MasasDev/custom-esp32-iot-pcb/esp32-c3-02.kicad_sch

## KiCad design esp32-c3-02.kicad_sch (2025-07-18)

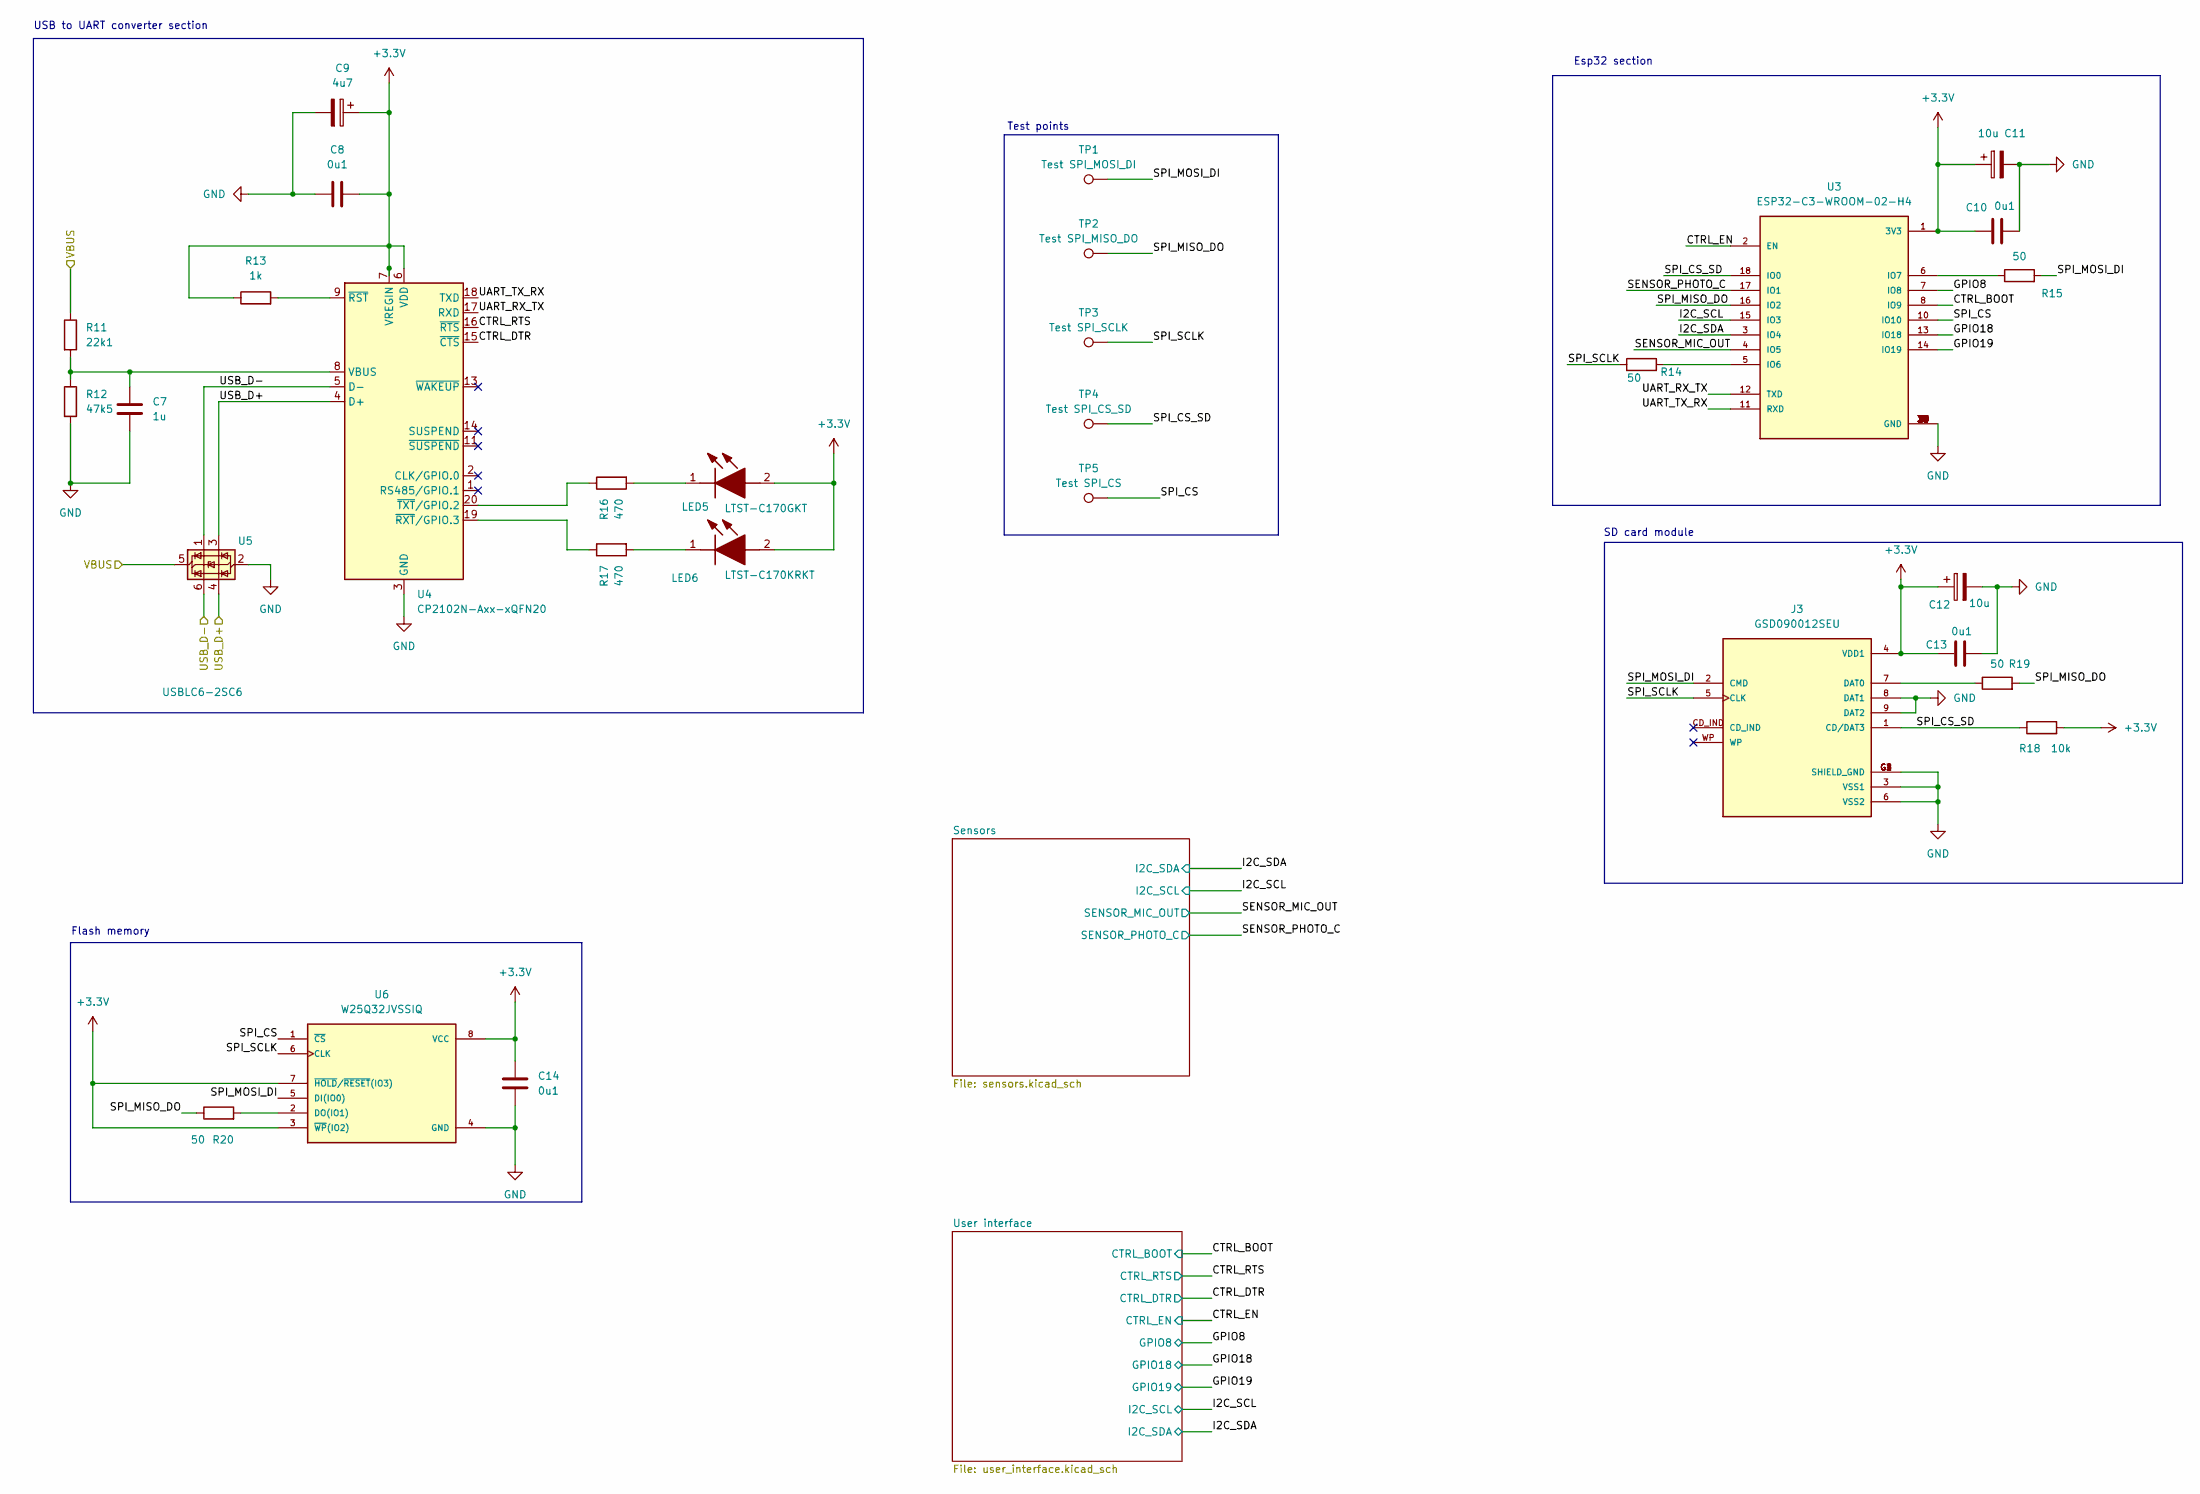
[picture p1: schematic esp32-c3-02.kicad_sch]

Parts:
C7: 1u; C_0805_2012Metric
C8, C10, C13, C14: 0u1; C_0805_2012Metric
C9: 4u7; T491A
C11, C12: 10u; T491A
J3: GSD090012SEU; AMPHENOL_GSD090012SEU; PARTREV E
LED5: LTST-C170GKT; LEDC2012X120N; Manufacturer_Part_Number LTST-C170GKT; Mouser Part Number 859-LTST-C170GKT
LED6: LTST-C170KRKT; LEDC2012X120N; Manufacturer_Part_Number LTST-C170KRKT; Mouser Part Number 859-LTST-C170KRKT
R11: 22k1; R_0805_2012Metric
R12: 47k5; R_0805_2012Metric
R13: 1k; R_0805_2012Metric
R14, R15, R19, R20: 50; R_0805_2012Metric
R16, R17: 470; R_0805_2012Metric
R18: 10k; R_0805_2012Metric
TP1: Test SPI_MOSI_DI; TestPoint_Pad_D1.0mm
TP2: Test SPI_MISO_DO; TestPoint_Pad_D1.0mm
TP3: Test SPI_SCLK; TestPoint_Pad_D1.0mm
TP4: Test SPI_CS_SD; TestPoint_Pad_D1.0mm
TP5: Test SPI_CS; TestPoint_Pad_D1.0mm
U3: ESP32-C3-WROOM-02-H4; MODULE_ESP32-C3-WROOM-02-H4
U4: CP2102N-Axx-xQFN20; SiliconLabs_QFN-20-1EP_3x3mm_P0.5mm
U5: USBLC6-2SC6; SOT-23-6
U6: W25Q32JVSSIQ; SOIC127P790X216-8N; M_PART_NUMBER W25QXX

Connections:
+3.3V: C8.2, C9.1, C10.1, C11.1, C12.1, C13.1, C14.1, J3.4 (VDD1), LED5.2 (A), LED6.2 (A), R13.1, R18.2, U3.1 (3V3), U4.6 (VDD), U4.7 (VREGIN), U6.3 (~WP(IO2)), U6.7 (~HOLD/~RESET(IO3)), U6.8 (VCC)
CTRL_BOOT: U3.8 (IO9)
CTRL_DTR: U4.15 (~CTS)
CTRL_EN: U3.2 (EN)
CTRL_RTS: U4.16 (~RTS)
GND: C7.2, C8.1, C9.2, C10.2, C11.2, C12.2, C13.2, C14.2, J3.3 (VSS1), J3.6 (VSS2), J3.8 (DAT1), J3.9 (DAT2), J3.G1 (SHIELD_GND), J3.G2 (SHIELD_GND), J3.G3 (SHIELD_GND), J3.G4 (SHIELD_GND), R12.2, U3.9 (GND), U3.19 (GND), U3.20 (GND), U3.21 (GND), U3.22 (GND), U3.23 (GND), U3.24 (GND), U3.25 (GND), U3.26 (GND), U3.27 (GND), U3.28 (GND), U3.29 (GND), U3.30 (GND), U3.31 (GND), U3.32 (GND), U3.33 (GND), U3.34 (GND), U3.35 (GND), U3.36 (GND), U3.37 (GND), U3.38 (GND), U3.39 (GND), U4.3 (GND), U4.12 (GND), U4.21 (GND), U5.2 (GND), U6.4 (GND)
GPIO8: U3.7 (IO8)
GPIO18: U3.13 (IO18)
GPIO19: U3.14 (IO19)
I2C_SCL: U3.15 (IO3)
I2C_SDA: U3.3 (IO4)
unnamed: C7.1, R11.2, R12.1, U4.8 (VBUS)
unnamed: J3.7 (DAT0), R19.1
unnamed: LED5.1 (K), R16.2
unnamed: LED6.1 (K), R17.2
unnamed: R13.2, U4.9 (~RST)
unnamed: R14.2, U3.5 (IO6)
unnamed: R15.1, U3.6 (IO7)
unnamed: R16.1, U4.20 (~TXT/GPIO.2)
unnamed: R17.1, U4.19 (~RXT/GPIO.3)
unnamed: R20.2, U6.2 (DO(IO1))
SENSOR_MIC_OUT: U3.4 (IO5)
SENSOR_PHOTO_C: U3.17 (IO1)
SPI_CS: TP5.1, U3.10 (IO10), U6.1 (~CS)
SPI_CS_SD: J3.1 (CD/DAT3), R18.1, TP4.1, U3.18 (IO0)
SPI_MISO_DO: R19.2, R20.1, TP2.1, U3.16 (IO2)
SPI_MOSI_DI: J3.2 (CMD), R15.2, TP1.1, U6.5 (DI(IO0))
SPI_SCLK: J3.5 (CLK), R14.1, TP3.1, U6.6 (CLK)
UART_RX_TX: U3.12 (TXD), U4.17 (RXD)
UART_TX_RX: U3.11 (RXD), U4.18 (TXD)
USB_D+: U4.4 (D+), U5.3 (I/O2), U5.4 (I/O2)
USB_D-: U4.5 (D-), U5.1 (I/O1), U5.6 (I/O1)
VBUS: R11.1, U5.5 (VBUS)

Notes on the sheet:
Test points
USB to UART converter section
Flash memory
Esp32 section
SD card module
