MasasDev/custom-esp32-iot-pcb/esp32_iot_board.kicad_sch

## KiCad design esp32_iot_board.kicad_sch (2025-07-18)

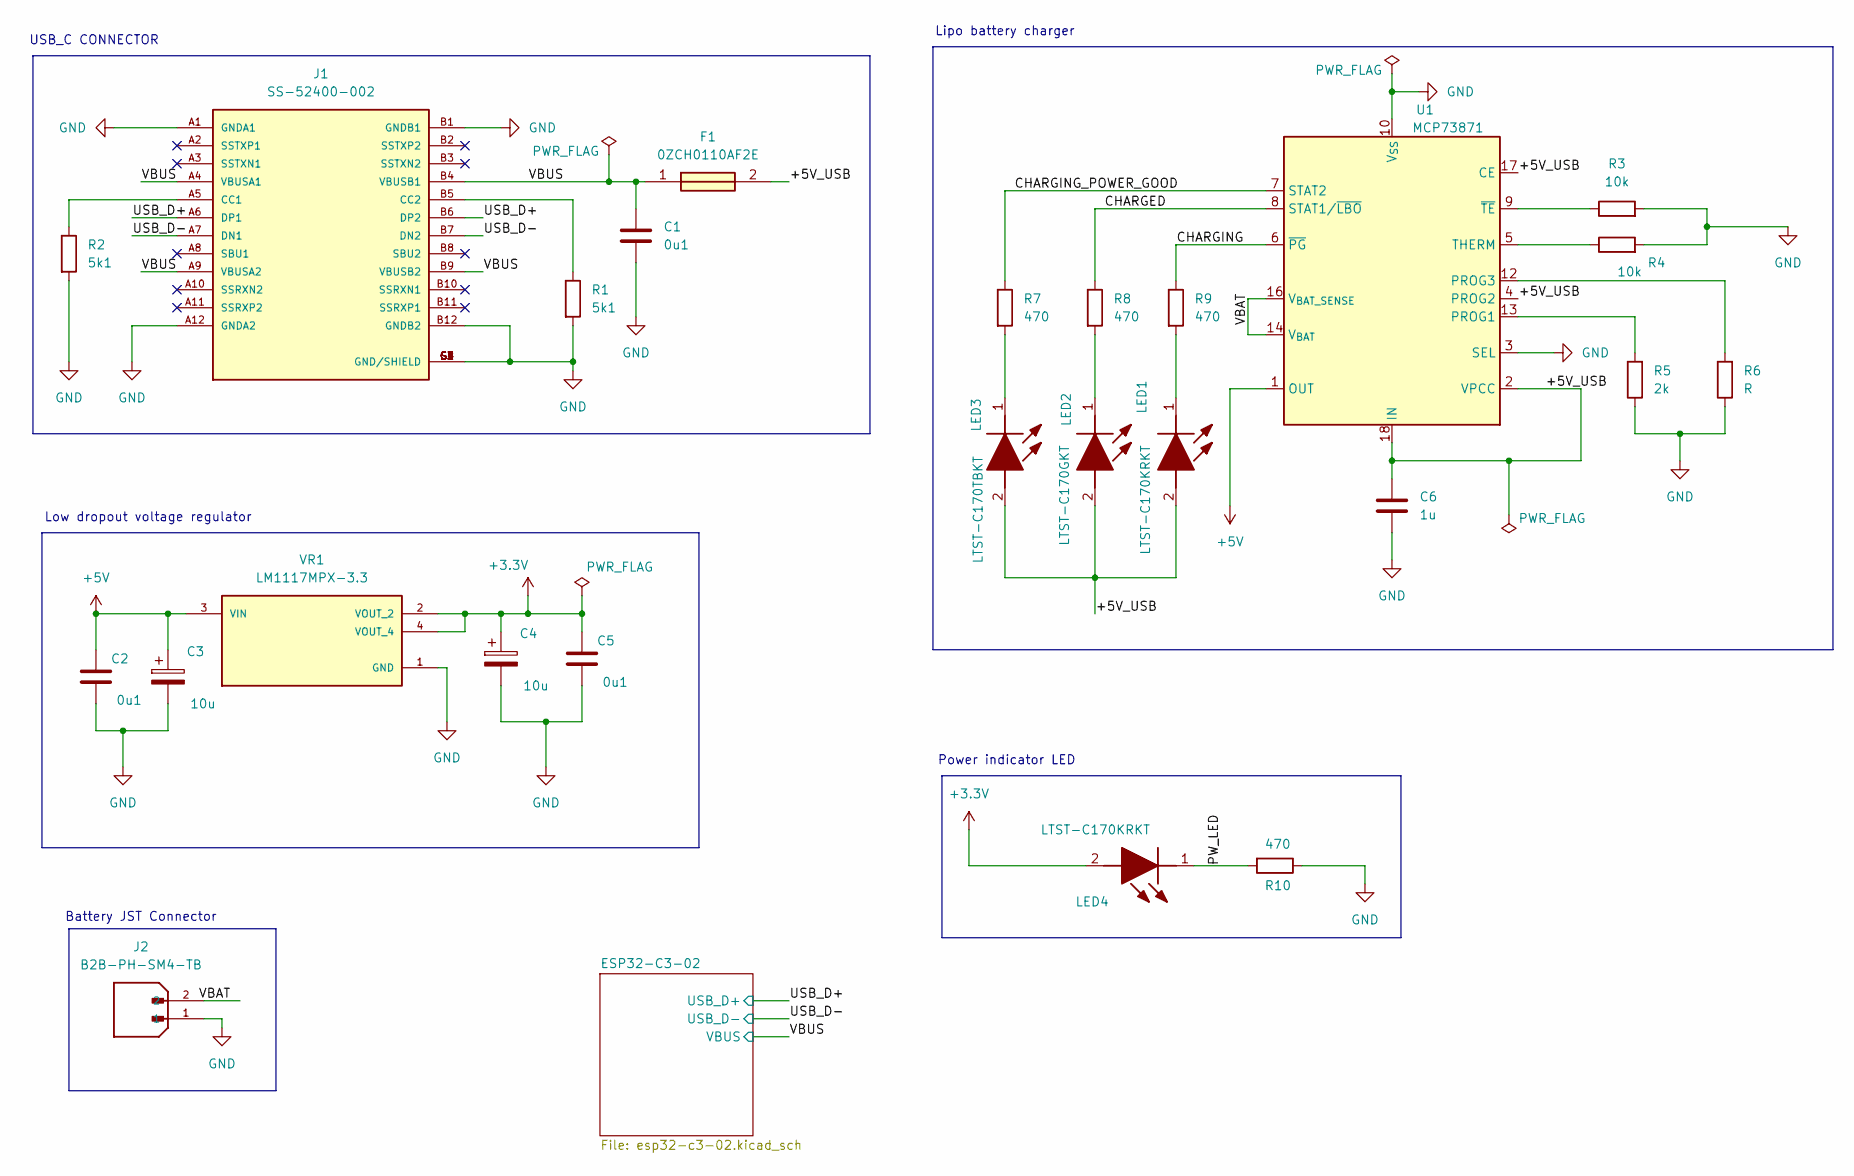
[picture p2: schematic esp32_iot_board.kicad_sch]

Parts:
C1, C2, C5: 0u1; C_0805_2012Metric
C3, C4: 10u; T491A
C6: 1u; C_0805_2012Metric
F1: 0ZCH0110AF2E; FUSC3226X100N; Manufacturer_Part_Number 0ZCH0110AF2E
J1: SS-52400-002; BELFUSE_SS-52400-002; PARTREV A0
J2: B2B-PH-SM4-TB; JST_B2B-PH-SM4-TB; PARTREV N/A
LED1, LED4: LTST-C170KRKT; LEDC2012X120N; Manufacturer_Part_Number LTST-C170KRKT; Mouser Part Number 859-LTST-C170KRKT
LED2: LTST-C170GKT; LEDC2012X120N; Manufacturer_Part_Number LTST-C170GKT; Mouser Part Number 859-LTST-C170GKT
LED3: LTST-C170TBKT; LEDC2012X120N; Manufacturer_Part_Number LTST-C170TBKT; Mouser Part Number 859-LTST-C170TBKT
R1, R2: 5k1; R_0805_2012Metric
R3, R4: 10k; R_0805_2012Metric
R5: 2k; R_0805_2012Metric
R6: R; R_0805_2012Metric
R7, R8, R9, R10: 470; R_0805_2012Metric
U1: MCP73871; QFN-20-1EP_4x4mm_P0.5mm_EP2.5x2.5mm
VR1: LM1117MPX-3.3; VREG_LM1117MPX-3.3

Connections:
+3.3V: C4.1, C5.1, LED4.2 (A), VR1.2 (VOUT_2), VR1.4 (VOUT_4)
+5V: C2.1, C3.1, U1.1 (OUT), U1.20 (OUT), VR1.3 (VIN)
+5V_USB: C6.1, F1.2, LED1.2 (A), LED2.2 (A), LED3.2 (A), U1.2 (VPCC), U1.4 (PROG2), U1.17 (CE), U1.18 (IN), U1.19 (IN)
CHARGED: R8.1, U1.8 (STAT1/~LBO)
CHARGING: R9.1, U1.6 (~PG)
CHARGING_POWER_GOOD: R7.1, U1.7 (STAT2)
GND: C1.2, C2.2, C3.2, C4.2, C5.2, C6.2, J1.A1 (GNDA1), J1.A12 (GNDA2), J1.B1 (GNDB1), J1.B12 (GNDB2), J1.G1 (GND/SHIELD), J1.G2 (GND/SHIELD), J1.G3 (GND/SHIELD), J1.G4 (GND/SHIELD), J1.S1 (GND/SHIELD), J1.S2 (GND/SHIELD), J1.S3 (GND/SHIELD), J1.S4 (GND/SHIELD), J2.1, R1.2, R2.2, R3.2, R4.2, R5.1, R6.1, R10.1, U1.3 (SEL), U1.10 (V_{SS}), U1.11 (V_{SS}), U1.21 (V_{SS}), VR1.1 (GND)
unnamed: J1.A5 (CC1), R2.1
unnamed: J1.B5 (CC2), R1.1
unnamed: LED1.1 (K), R9.2
unnamed: LED2.1 (K), R8.2
unnamed: LED3.1 (K), R7.2
unnamed: R3.1, U1.9 (~TE)
unnamed: R4.1, U1.5 (THERM)
unnamed: R5.2, U1.13 (PROG1)
unnamed: R6.2, U1.12 (PROG3)
PW_LED: LED4.1 (K), R10.2
USB_D+: J1.A6 (DP1), J1.B6 (DP2)
USB_D-: J1.A7 (DN1), J1.B7 (DN2)
VBAT: J2.2, U1.14 (V_{BAT}), U1.15 (V_{BAT}), U1.16 (V_{BAT_SENSE})
VBUS: C1.1, F1.1, J1.A4 (VBUSA1), J1.A9 (VBUSA2), J1.B4 (VBUSB1), J1.B9 (VBUSB2)

Notes on the sheet:
Lipo battery charger
Low dropout voltage regulator
Power indicator LED
USB_C CONNECTOR
Battery JST Connector
