MasasDev/custom-esp32-iot-pcb/sensors.kicad_sch

## KiCad design sensors.kicad_sch (2025-07-18)

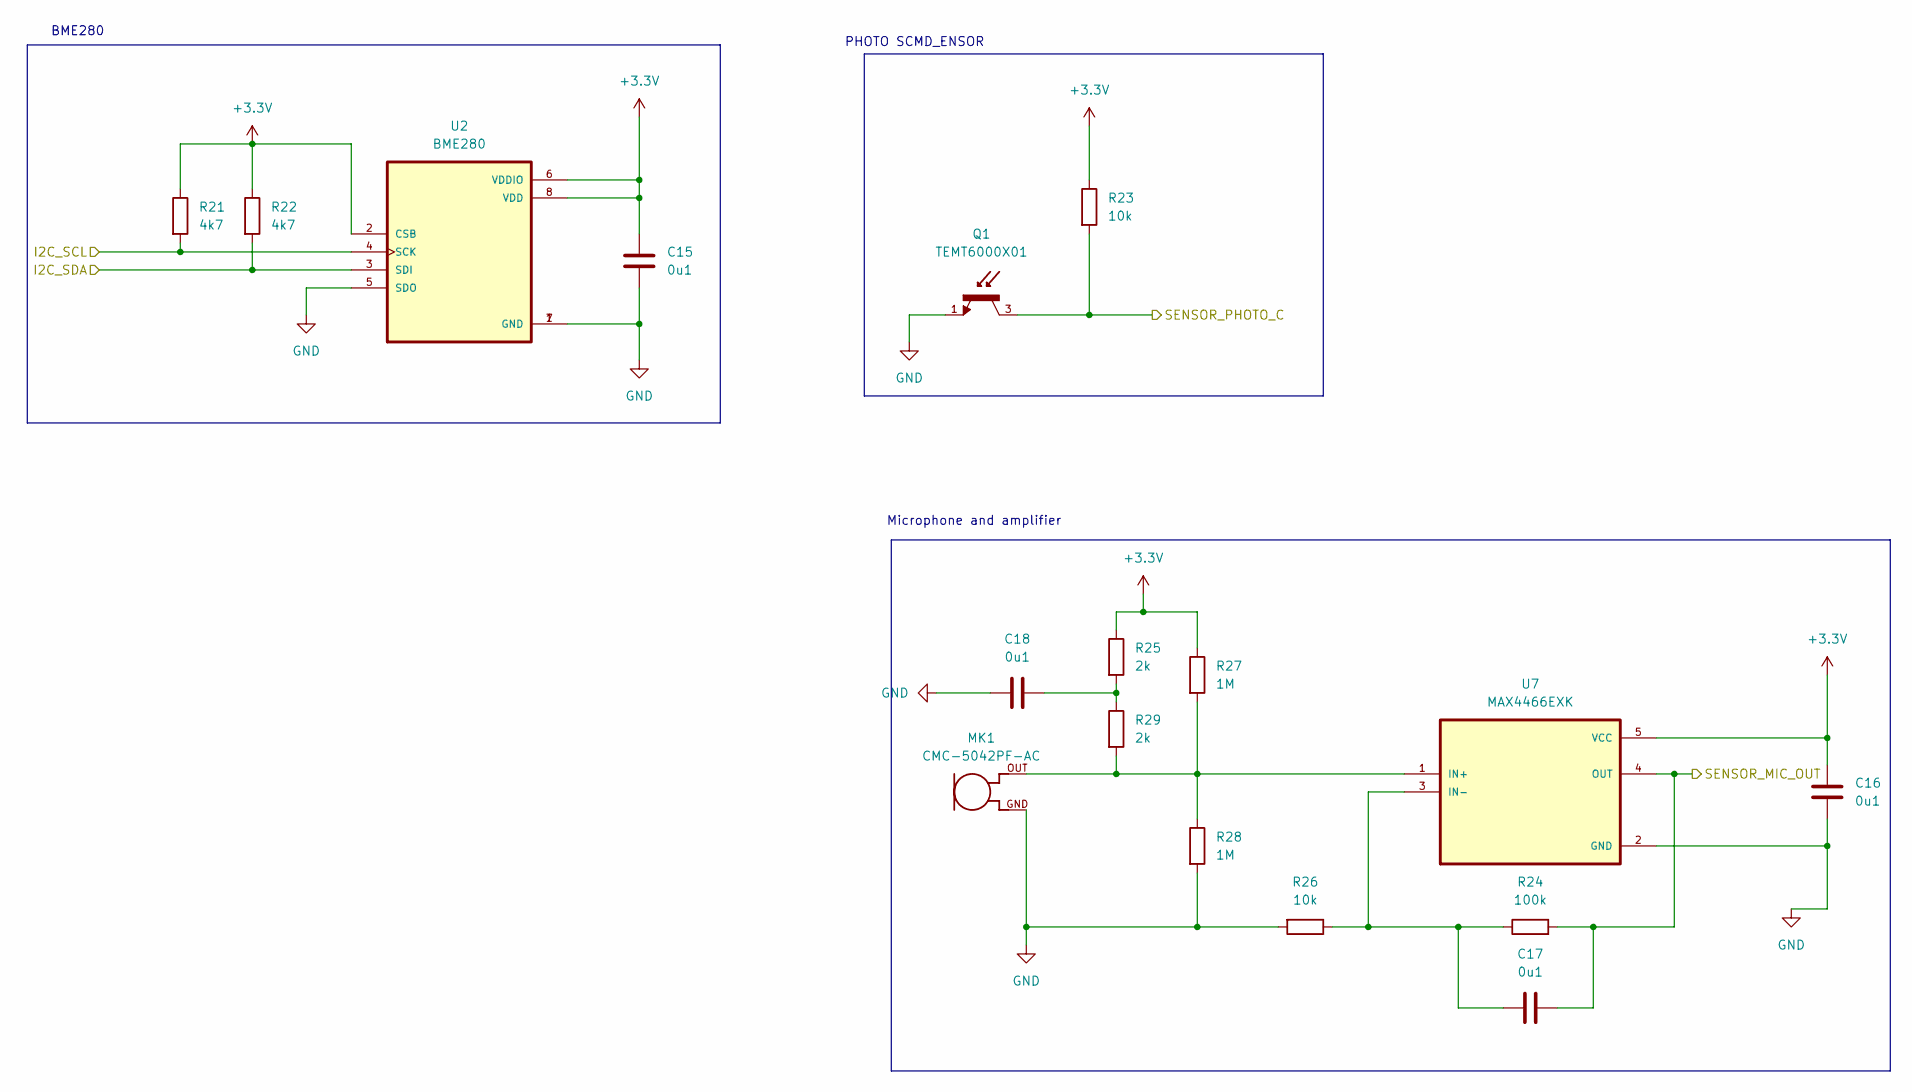
[picture p3: schematic sensors.kicad_sch]

Parts:
C15, C16, C17, C18: 0u1; C_0805_2012Metric
MK1: CMC-5042PF-AC; CUI_CMC-5042PF-AC
Q1: TEMT6000X01; TRANS_TEMT6000X01; PARTREV 1.9
R21, R22: 4k7; R_0805_2012Metric
R23, R26: 10k; R_0805_2012Metric
R24: 100k; R_0805_2012Metric
R25, R29: 2k; R_0805_2012Metric
R27, R28: 1M; R_0805_2012Metric
U2: BME280; PSON65P250X250X100-8N
U7: MAX4466EXK; SOT65P210X110-5N

Connections:
+3.3V: C15.1, C16.1, R21.1, R22.1, R23.1, R25.1, R27.1, U2.2 (CSB), U2.6 (VDDIO), U2.8 (VDD), U7.5 (VCC)
GND: C15.2, C16.2, C18.1, MK1.GND, Q1.1, R26.2, R28.2, U2.1 (GND), U2.5 (SDO), U2.7 (GND), U7.2 (GND)
I2C_SCL: R21.2, U2.4 (SCK)
I2C_SDA: R22.2, U2.3 (SDI)
unnamed: C17.1, R24.1, R26.1, U7.3 (IN-)
unnamed: C18.2, R25.2, R29.1
unnamed: MK1.OUT, R27.2, R28.1, R29.2, U7.1 (IN+)
SENSOR_MIC_OUT: C17.2, R24.2, U7.4 (OUT)
SENSOR_PHOTO_C: Q1.3, R23.2

Notes on the sheet:
Microphone and amplifier
PHOTO SCMD_ENSOR
BME280
