MasasDev/custom-esp32-iot-pcb/user_interface.kicad_sch

## KiCad design user_interface.kicad_sch (2025-07-18)

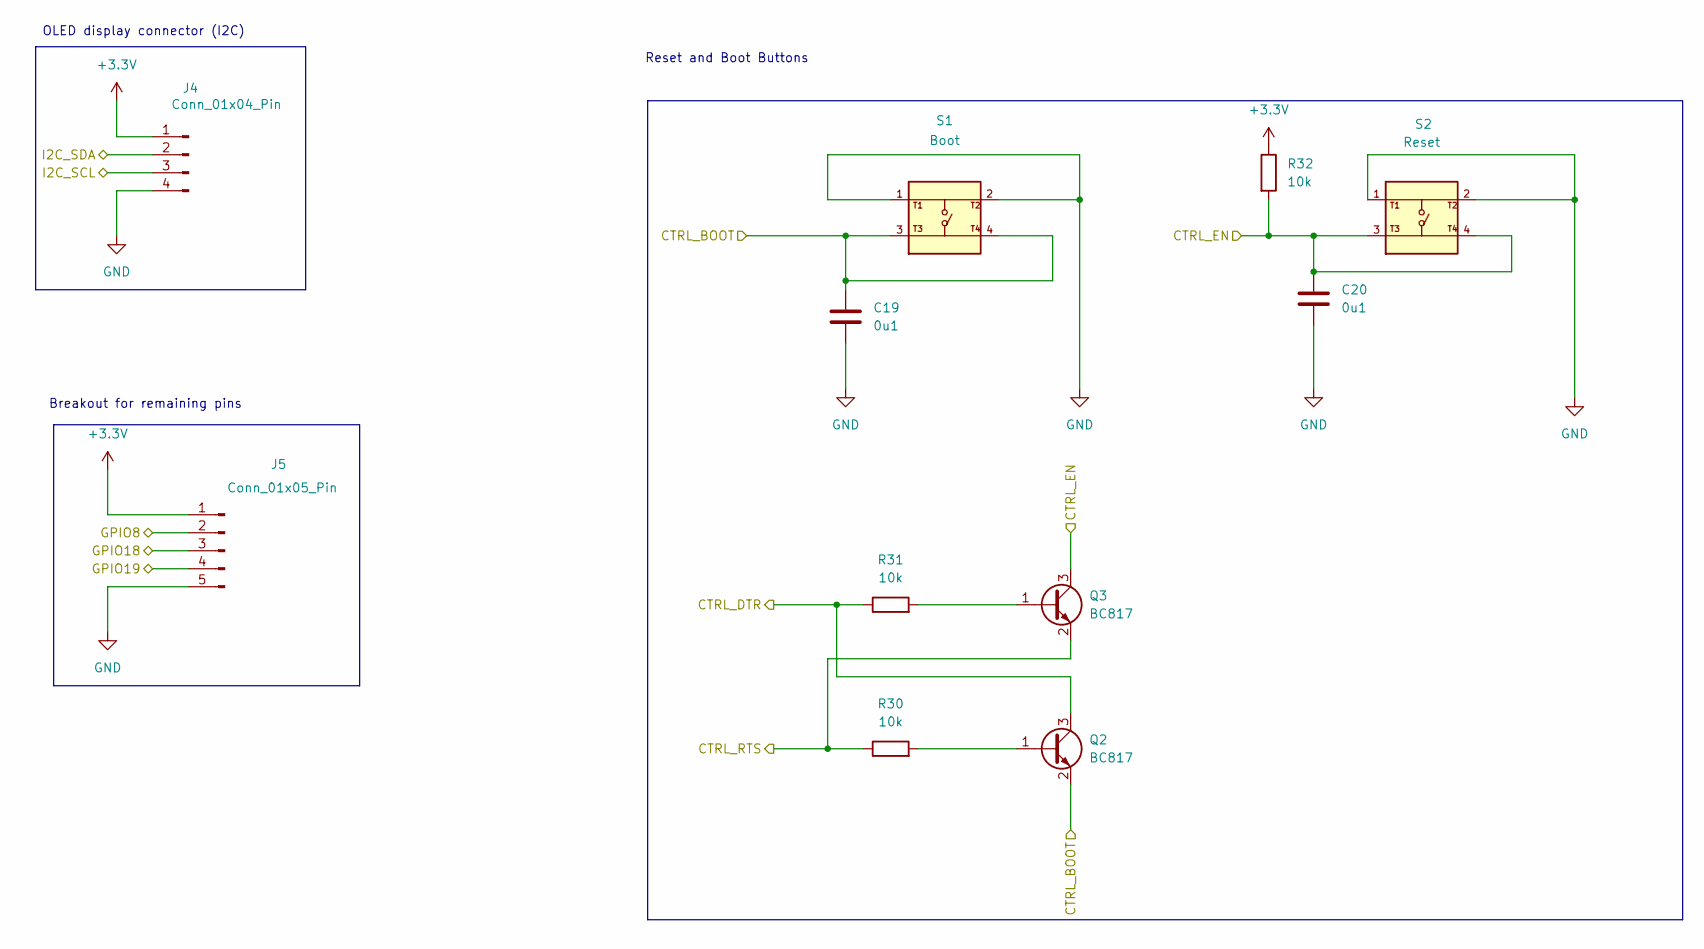
[picture p4: schematic user_interface.kicad_sch]

Parts:
C19, C20: 0u1; C_0805_2012Metric
J4: Conn_01x04_Pin; PinHeader_1x04_P2.54mm_Vertical
J5: Conn_01x05_Pin; PinHeader_1x05_P2.54mm_Vertical
Q2, Q3: BC817; SOT-23
R30, R31, R32: 10k; R_0805_2012Metric
S1: Boot; SW_USLPT2819DT2TR; PARTREV P
S2: Reset; SW_USLPT2819DT2TR; PARTREV P

Connections:
+3.3V: J4.1, J5.1, R32.1
CTRL_BOOT: C19.2, Q2.2 (E), S1.3, S1.4
CTRL_DTR: Q2.3 (C), R31.1
CTRL_EN: C20.2, Q3.3 (C), R32.2, S2.3, S2.4
CTRL_RTS: Q3.2 (E), R30.1
GND: C19.1, C20.1, J4.4, J5.5, S1.1, S1.2, S2.1, S2.2
GPIO8: J5.2
GPIO18: J5.3
GPIO19: J5.4
I2C_SCL: J4.3
I2C_SDA: J4.2
unnamed: Q2.1 (B), R30.2
unnamed: Q3.1 (B), R31.2

Notes on the sheet:
Breakout for remaining pins
OLED display connector (I2C)
Reset and Boot Buttons
