MasasDev/custom-esp32-iot-pcb/(commit log)

2025-07-17 feat: add libraries folder and initial schematic sections
    - Added a libraries folder containing custom symbols, footprints, and 3D models.
    - Populated the schematic's front page with five key sections:
    - USB-C Connector
    - LiPo Battery Charger
    - Low Dropout Voltage Regulator
    - Power Indicator LED
    - Battery JST Connector
    - Created a second schematic page dedicated to ESP32 circuit design.
    - Included relevant datasheets for reference.
    [esp32-c3-02.kicad_sch, esp32_iot_board.kicad_sch]
2025-07-18 feat: add sensor and user interface schematic sheets, update ESP32 sheet
    - Added Sensors schematic sheet for integrating all sensor-related components.
    - Added User Interface sheet to host user-interaction components (e.g., buttons, displays).
    - Populated the ESP32 sheet with the following sections:
    - USB-to-UART Connector
    - ESP32 Module
    - Flash Memory
    - SD Card Module
    - Each section is modular and self-contained, designed for clarity and easy testing.
    - Enabled signal access (e.g., USB_D+, USB_D-, VBUS) in the USB-to-UART section via hierarchical labels from the parent sheet.
    - Added test points on SPI lines within the ESP32 sheet to facilitate hardware debugging and validat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
    [esp32-c3-02.kicad_sch, esp32_iot_board.kicad_sch, sensors.kicad_sch, user_interface.kicad_sch]
2025-07-18 feat: populate sensor and user interface schematic sheets; assign footprints
    - Populated the Sensors schematic sheet with the following components:
    - BME280: Temperature and humidity sensor
    - Photoresistor: For measuring ambient light levels
    - Sound Sensor Section: Includes a microphone and preamplifier to amplify audio signals for microcontroller processing
    - Populated the User Interface schematic sheet with:
    - Boot and reset controls for the microcontroller
    - Breakout lines for external devices:
    - One for I²C-based peripherals (e.g., OLED display)
    - One for general-purpose I/O devices
    - Both the Sensors and User Interface sheets access necessary pins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
    [esp32-c3-02.kicad_sch, esp32_iot_board.kicad_sch, sensors.kicad_sch, user_interface.kicad_sch]
2025-07-18 refactor: update label naming for net class scope resolution; set up PCB constraints
    - Renamed schematic labels to follow a net class–based naming convention for
    better scope resolution (e.g., labels in the SPI net class now use a SPI_ prefix).
    - Configured the PCB stack-up to use a 4-layer board.
    - Applied design constraints (e.g., trace width, spacing) based on the
    PCB manufacturer's recommended specifications.
    [esp32-c3-02.kicad_sch, esp32_iot_board.kicad_pcb, esp32_iot_board.kicad_sch, sensors.kicad_sch, user_interface.kicad_sch]
